radit057/Solar-PV/Solar_Portfolio_Projects_2-5/P2_Gazipur_50kWp_Industrial/P2_Gazipur_50kWp_Industrial_hourly_simulation.csv

 | ghi | poa | tcell | pdc_w | pdc_net_w | pac_w
2026-01-01 00:30:00+06:00 | 0.000 | 0.000 | 15.787 | 0.000 | 0.000 | 0.000
2026-01-01 01:30:00+06:00 | 0.000 | 0.000 | 15.264 | 0.000 | 0.000 | 0.000
2026-01-01 02:30:00+06:00 | 0.000 | 0.000 | 14.994 | 0.000 | 0.000 | 0.000
2026-01-01 03:30:00+06:00 | 0.000 | 0.000 | 14.994 | 0.000 | 0.000 | 0.000
2026-01-01 04:30:00+06:00 | 0.000 | 0.000 | 15.264 | 0.000 | 0.000 | 0.000
2026-01-01 05:30:00+06:00 | 0.000 | 0.000 | 15.787 | 0.000 | 0.000 | 0.000
2026-01-01 06:30:00+06:00 | 0.000 | 0.000 | 16.525 | 0.000 | 0.000 | 0.000
2026-01-01 07:30:00+06:00 | 77.383 | 93.540 | 21.950 | 3693.241 | 3388.515 | 3112.805
2026-01-01 08:30:00+06:00 | 261.454 | 289.607 | 32.434 | 12836.957 | 11777.790 | 11386.707
2026-01-01 09:30:00+06:00 | 425.286 | 461.666 | 41.794 | 20607.043 | 18906.774 | 18373.904
2026-01-01 10:30:00+06:00 | 544.030 | 585.990 | 48.811 | 25800.628 | 23671.840 | 23021.788
2026-01-01 11:30:00+06:00 | 606.860 | 651.769 | 52.894 | 28357.573 | 26017.814 | 25303.473
2026-01-01 12:30:00+06:00 | 608.729 | 653.723 | 53.727 | 28353.316 | 26013.909 | 25299.679
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
