radit057/Solar-PV/Solar_Portfolio_Projects_2-5/P2_Gazipur_50kWp_Industrial/P2_Gazipur_50kWp_Industrial_monthly_simulation.csv

 | GHI_kWh_m2 | POA_kWh_m2 | E_ac_kWh | PR
Jan | 121.100 | 130.651 | 5082.574 | 0.786
Feb | 130.500 | 137.929 | 5252.534 | 0.769
Mar | 167.300 | 172.779 | 6426.839 | 0.751
Apr | 158.600 | 160.329 | 5966.073 | 0.752
May | 152.100 | 151.764 | 5678.534 | 0.756
Jun | 120.400 | 119.570 | 4527.491 | 0.765
Jul | 117.300 | 116.780 | 4447.690 | 0.769
Aug | 124.800 | 125.535 | 4731.529 | 0.761
Sep | 118.700 | 121.018 | 4552.201 | 0.760
Oct | 122.800 | 128.045 | 4856.853 | 0.766
Nov | 114.300 | 122.190 | 4680.217 | 0.774
Dec | 108.500 | 117.185 | 4553.744 | 0.785
