radit057/Solar-PV/Solar_Portfolio_Projects_2-5/P3_Uttara_5kWp_Hybrid/P3_Uttara_5kWp_Hybrid_hourly_simulation.csv

 | ghi | poa | tcell | pdc_w | pdc_net_w | pac_w
2026-01-01 00:30:00+06:00 | 0.000 | 0.000 | 15.787 | 0.000 | 0.000 | 0.000
2026-01-01 01:30:00+06:00 | 0.000 | 0.000 | 15.264 | 0.000 | 0.000 | 0.000
2026-01-01 02:30:00+06:00 | 0.000 | 0.000 | 14.994 | 0.000 | 0.000 | 0.000
2026-01-01 03:30:00+06:00 | 0.000 | 0.000 | 14.994 | 0.000 | 0.000 | 0.000
2026-01-01 04:30:00+06:00 | 0.000 | 0.000 | 15.264 | 0.000 | 0.000 | 0.000
2026-01-01 05:30:00+06:00 | 0.000 | 0.000 | 15.787 | 0.000 | 0.000 | 0.000
2026-01-01 06:30:00+06:00 | 0.000 | 0.000 | 16.525 | 0.000 | 0.000 | 0.000
2026-01-01 07:30:00+06:00 | 77.827 | 124.452 | 20.965 | 534.063 | 490.126 | 454.954
2026-01-01 08:30:00+06:00 | 261.768 | 340.597 | 28.115 | 1575.697 | 1446.066 | 1397.625
2026-01-01 09:30:00+06:00 | 425.409 | 525.580 | 34.415 | 2439.417 | 2238.729 | 2174.900
2026-01-01 10:30:00+06:00 | 544.030 | 658.485 | 39.200 | 3024.946 | 2776.087 | 2699.567
2026-01-01 11:30:00+06:00 | 606.836 | 728.816 | 42.103 | 3318.434 | 3045.430 | 2961.861
2026-01-01 12:30:00+06:00 | 608.784 | 730.989 | 42.903 | 3318.555 | 3045.541 | 2961.969
2026-01-01 13:30:00+06:00 | 549.723 | 664.827 | 41.545 | 3028.338 | 2779.199 | 2702.601
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
