radit057/Solar-PV/Solar_Portfolio_Projects_2-5/P3_Uttara_5kWp_Hybrid/P3_Uttara_5kWp_Hybrid_monthly_simulation.csv

 | GHI_kWh_m2 | POA_kWh_m2 | E_ac_kWh | PR
Jan | 121.100 | 147.241 | 597.774 | 0.820
Feb | 130.500 | 150.238 | 598.446 | 0.805
Mar | 167.300 | 180.569 | 704.789 | 0.789
Apr | 158.600 | 160.993 | 625.860 | 0.785
May | 152.100 | 148.605 | 578.389 | 0.786
Jun | 120.400 | 116.135 | 453.481 | 0.789
Jul | 117.300 | 113.945 | 446.433 | 0.792
Aug | 124.800 | 124.915 | 487.245 | 0.788
Sep | 118.700 | 123.644 | 482.171 | 0.788
Oct | 122.800 | 136.258 | 536.541 | 0.795
Nov | 114.300 | 135.736 | 541.287 | 0.806
Dec | 108.500 | 132.344 | 535.385 | 0.817
