radit057/Solar-PV/Solar_Portfolio_Projects_2-5/P4_AUST_30kWp_Solar_Carport_EV/P4_AUST_30kWp_Solar_Carport_EV_hourly_simulation.csv

 | ghi | poa | tcell | pdc_w | pdc_net_w | pac_w
2026-01-01 00:30:00+06:00 | 0.000 | 0.000 | 15.787 | 0.000 | 0.000 | 0.000
2026-01-01 01:30:00+06:00 | 0.000 | 0.000 | 15.264 | 0.000 | 0.000 | 0.000
2026-01-01 02:30:00+06:00 | 0.000 | 0.000 | 14.994 | 0.000 | 0.000 | 0.000
2026-01-01 03:30:00+06:00 | 0.000 | 0.000 | 14.994 | 0.000 | 0.000 | 0.000
2026-01-01 04:30:00+06:00 | 0.000 | 0.000 | 15.264 | 0.000 | 0.000 | 0.000
2026-01-01 05:30:00+06:00 | 0.000 | 0.000 | 15.787 | 0.000 | 0.000 | 0.000
2026-01-01 06:30:00+06:00 | 0.000 | 0.000 | 16.525 | 0.000 | 0.000 | 0.000
2026-01-01 07:30:00+06:00 | 78.522 | 110.318 | 20.564 | 2750.730 | 2550.059 | 2373.112
2026-01-01 08:30:00+06:00 | 262.270 | 316.566 | 27.432 | 8710.258 | 8074.828 | 7817.895
2026-01-01 09:30:00+06:00 | 425.588 | 495.100 | 33.549 | 13765.265 | 12761.062 | 12406.010
2026-01-01 10:30:00+06:00 | 543.945 | 623.721 | 38.212 | 17211.593 | 15955.974 | 15518.098
2026-01-01 11:30:00+06:00 | 606.586 | 691.781 | 41.051 | 18941.264 | 17559.462 | 17075.149
2026-01-01 12:30:00+06:00 | 608.490 | 693.843 | 41.847 | 18942.767 | 17560.855 | 17076.501
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
