radit057/Solar-PV/Solar_Portfolio_Projects_2-5/P4_AUST_30kWp_Solar_Carport_EV/P4_AUST_30kWp_Solar_Carport_EV_monthly_simulation.csv

 | GHI_kWh_m2 | POA_kWh_m2 | E_ac_kWh | PR
Jan | 121.100 | 139.297 | 3425.817 | 0.828
Feb | 130.500 | 144.466 | 3490.303 | 0.813
Mar | 167.300 | 177.147 | 4196.583 | 0.798
Apr | 158.600 | 161.071 | 3801.596 | 0.795
May | 152.100 | 150.547 | 3560.196 | 0.796
Jun | 120.400 | 118.117 | 2805.403 | 0.800
Jul | 117.300 | 115.629 | 2756.512 | 0.803
Aug | 124.800 | 125.533 | 2977.343 | 0.799
Sep | 118.700 | 122.631 | 2906.542 | 0.798
Oct | 122.800 | 132.487 | 3167.216 | 0.805
Nov | 114.300 | 129.291 | 3125.879 | 0.814
Dec | 108.500 | 125.058 | 3064.289 | 0.825
