radit057/Solar-PV/Solar_Portfolio_Projects_2-5/P5_Rajshahi_8kWp_Solar_Irrigation_Pump/P5_Rajshahi_8kWp_Solar_Irrigation_Pump_hourly_simulation.csv

 | ghi | poa | tcell | pdc_w | pdc_net_w | pac_w
2026-01-01 00:30:00+06:00 | 0.000 | 0.000 | 15.787 | 0.000 | 0.000 | 0.000
2026-01-01 01:30:00+06:00 | 0.000 | 0.000 | 15.264 | 0.000 | 0.000 | 0.000
2026-01-01 02:30:00+06:00 | 0.000 | 0.000 | 14.994 | 0.000 | 0.000 | 0.000
2026-01-01 03:30:00+06:00 | 0.000 | 0.000 | 14.994 | 0.000 | 0.000 | 0.000
2026-01-01 04:30:00+06:00 | 0.000 | 0.000 | 15.264 | 0.000 | 0.000 | 0.000
2026-01-01 05:30:00+06:00 | 0.000 | 0.000 | 15.787 | 0.000 | 0.000 | 0.000
2026-01-01 06:30:00+06:00 | 0.000 | 0.000 | 16.525 | 0.000 | 0.000 | 0.000
2026-01-01 07:30:00+06:00 | 56.338 | 118.765 | 20.804 | 870.219 | 802.430 | 748.932
2026-01-01 08:30:00+06:00 | 239.165 | 353.915 | 28.494 | 2749.846 | 2535.637 | 2456.496
2026-01-01 09:30:00+06:00 | 407.668 | 553.853 | 35.219 | 4289.908 | 3955.730 | 3846.135
2026-01-01 10:30:00+06:00 | 532.802 | 699.766 | 40.373 | 5346.676 | 4930.177 | 4794.764
2026-01-01 11:30:00+06:00 | 602.886 | 781.319 | 43.595 | 5905.490 | 5445.460 | 5294.776
2026-01-01 12:30:00+06:00 | 612.271 | 792.232 | 44.643 | 5965.015 | 5500.348 | 5347.971
2026-01-01 13:30:00+06:00 | 560.226 | 731.628 | 43.443 | 5529.749 | 5098.990 | 4958.697
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
