radit057/Solar-PV/Solar_Portfolio_Projects_2-5/P5_Rajshahi_8kWp_Solar_Irrigation_Pump/P5_Rajshahi_8kWp_Solar_Irrigation_Pump_monthly_simulation.csv

 | GHI_kWh_m2 | POA_kWh_m2 | E_ac_kWh | PR
Jan | 121.100 | 159.712 | 1087.033 | 0.825
Feb | 130.500 | 158.973 | 1060.194 | 0.808
Mar | 167.300 | 184.366 | 1205.126 | 0.792
Apr | 158.600 | 158.849 | 1034.256 | 0.789
May | 152.100 | 143.341 | 934.546 | 0.790
Jun | 120.400 | 111.267 | 727.822 | 0.793
Jul | 117.300 | 109.626 | 719.439 | 0.795
Aug | 124.800 | 122.318 | 799.500 | 0.792
Sep | 118.700 | 124.009 | 810.320 | 0.792
Oct | 122.800 | 141.284 | 932.517 | 0.800
Nov | 114.300 | 145.598 | 974.635 | 0.811
Dec | 108.500 | 143.932 | 977.623 | 0.823
