radit057/Solar-PV/Solar_Portfolio_Projects_2-5/P2_Gazipur_50kWp_Industrial/P2_Gazipur_50kWp_Industrial_drawing.png

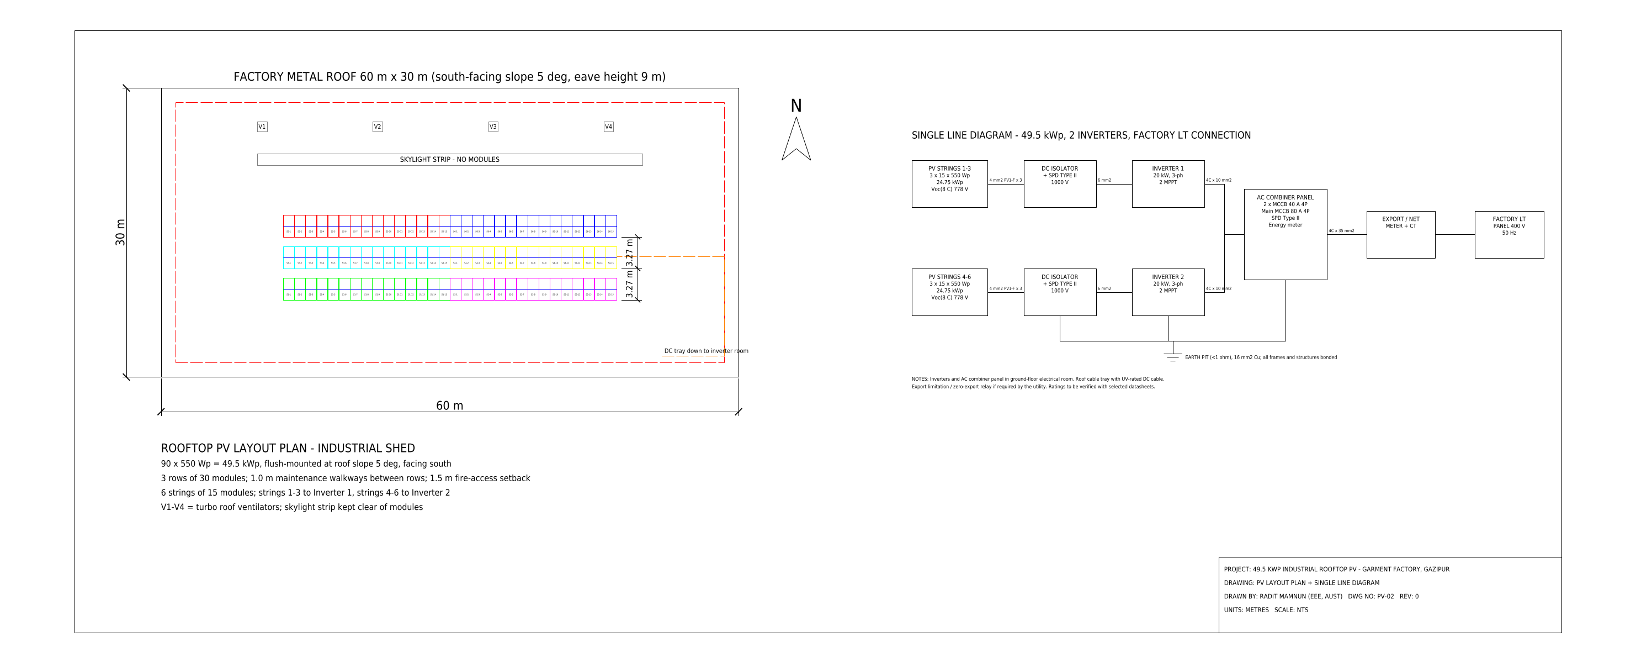
Solar_Portfolio_Projects_2-5/P2_Gazipur_50kWp_Industrial/P2_Gazipur_50kWp_Industrial_drawing.png
