radit057/Solar-PV/Solar_Portfolio_Projects_2-5/P3_Uttara_5kWp_Hybrid/P3_Uttara_5kWp_Hybrid_drawing.png

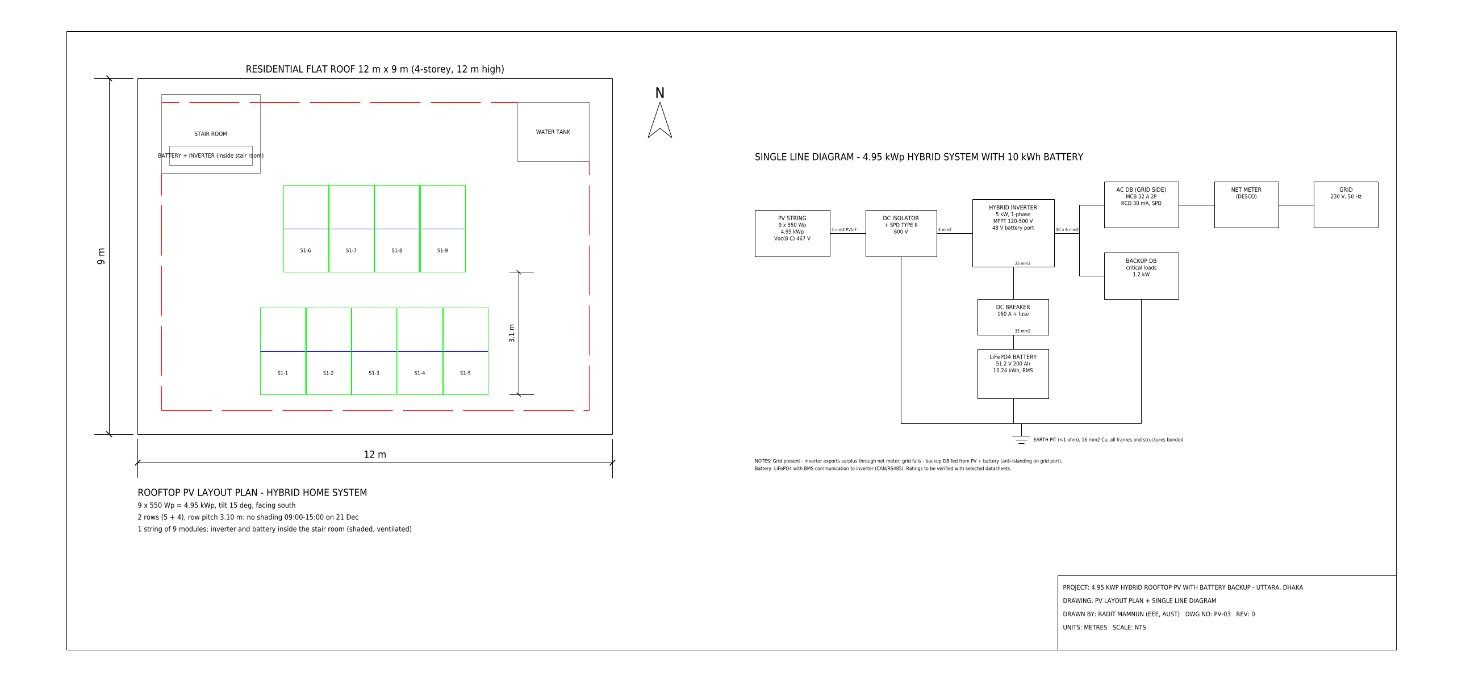
Solar_Portfolio_Projects_2-5/P3_Uttara_5kWp_Hybrid/P3_Uttara_5kWp_Hybrid_drawing.png
