radit057/Solar-PV/Solar_Portfolio_Projects_2-5/P4_AUST_30kWp_Solar_Carport_EV/P4_AUST_30kWp_Solar_Carport_EV_drawing.png

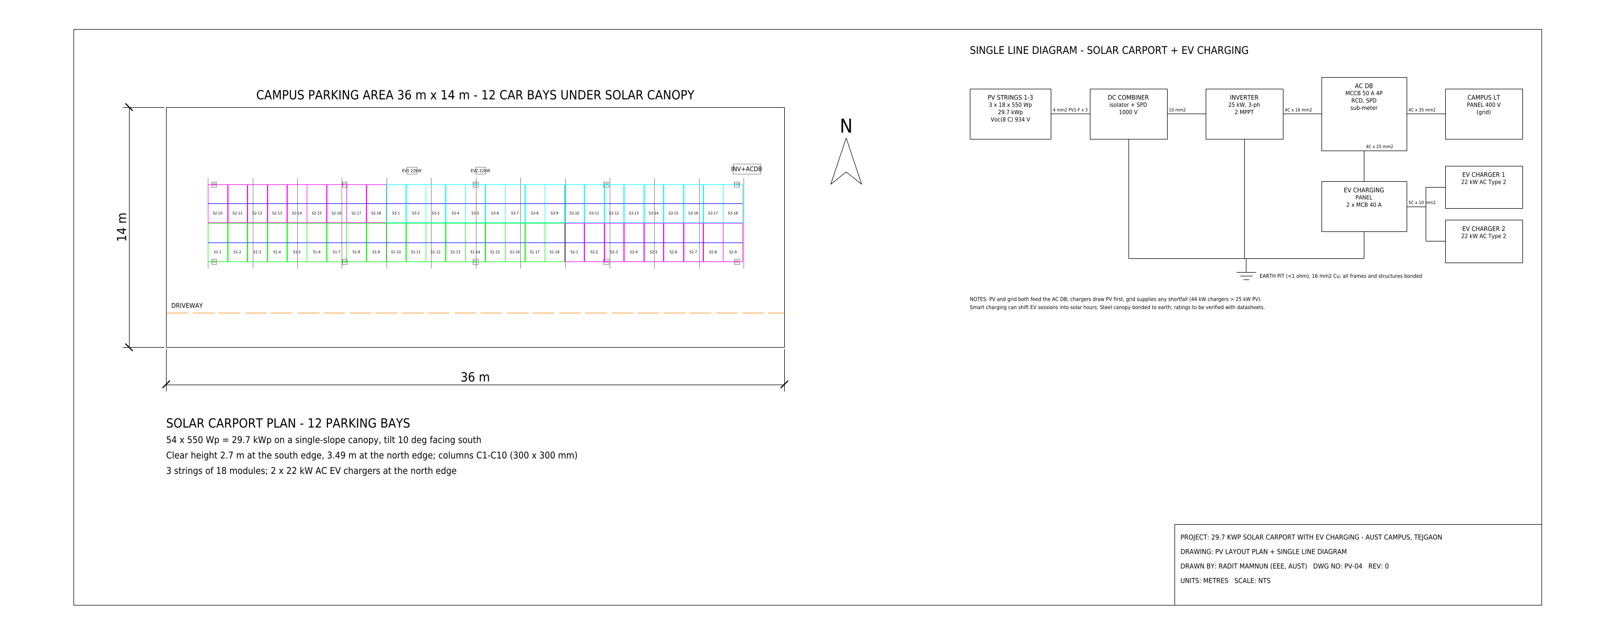
Solar_Portfolio_Projects_2-5/P4_AUST_30kWp_Solar_Carport_EV/P4_AUST_30kWp_Solar_Carport_EV_drawing.png
