radit057/Solar-PV/Solar_Portfolio_Projects_2-5/P4_AUST_30kWp_Solar_Carport_EV/P4_AUST_30kWp_Solar_Carport_EV_fig_ev_share.png

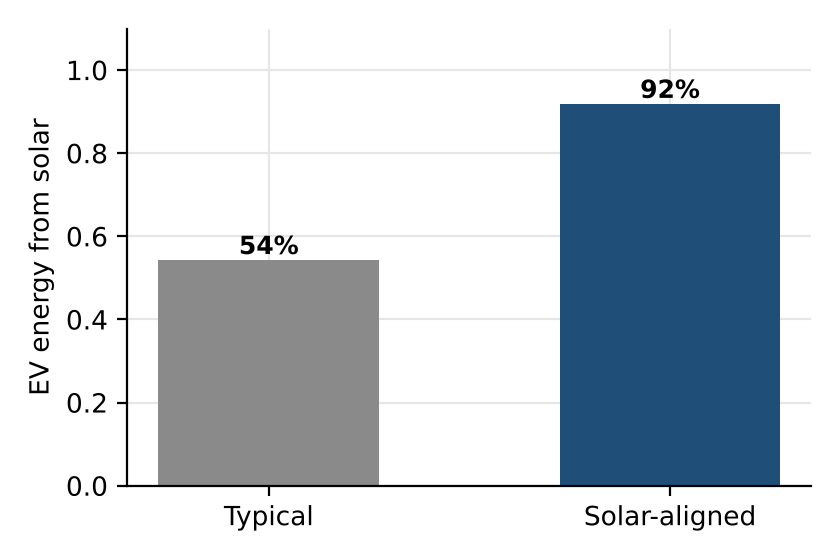
Solar_Portfolio_Projects_2-5/P4_AUST_30kWp_Solar_Carport_EV/P4_AUST_30kWp_Solar_Carport_EV_fig_ev_share.png
