radit057/Solar-PV/Solar_Portfolio_Projects_2-5/P5_Rajshahi_8kWp_Solar_Irrigation_Pump/P5_Rajshahi_8kWp_Solar_Irrigation_Pump_drawing.png

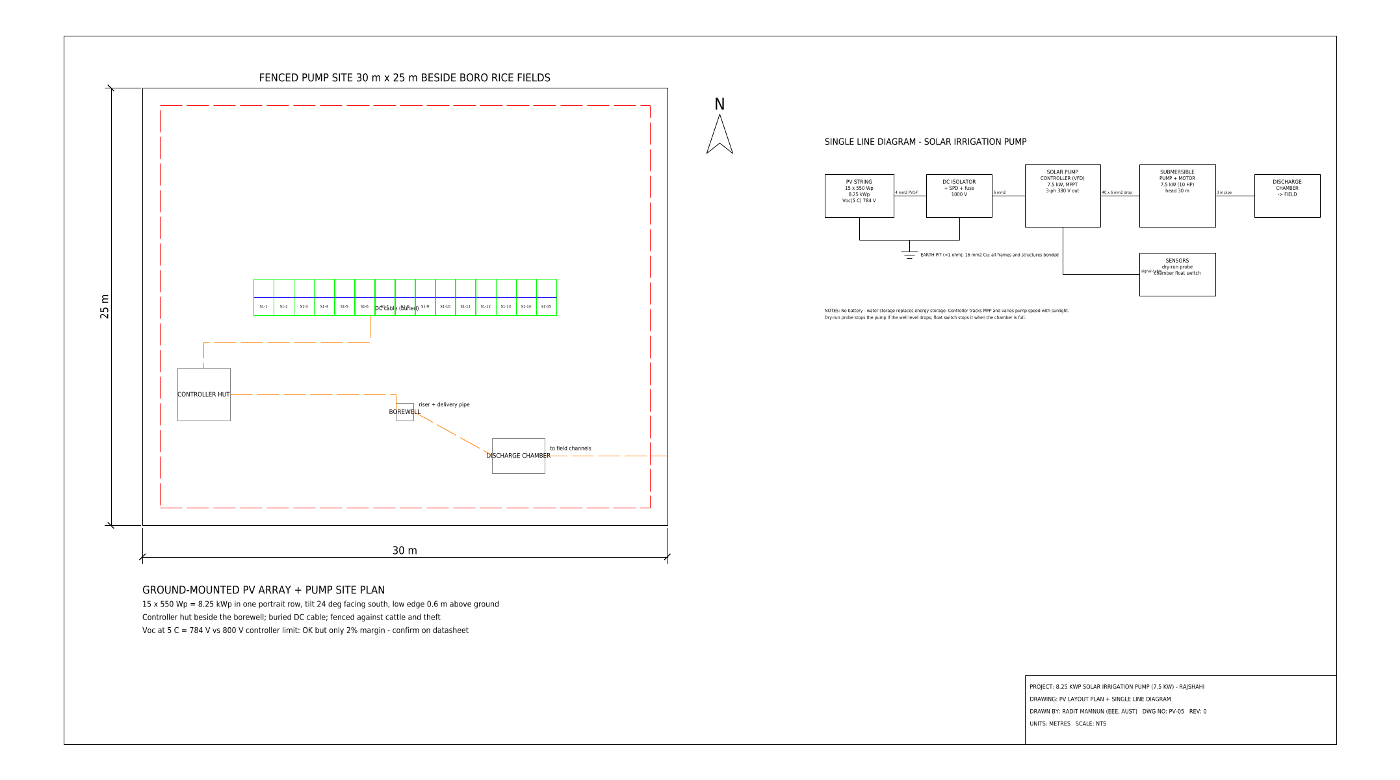
Solar_Portfolio_Projects_2-5/P5_Rajshahi_8kWp_Solar_Irrigation_Pump/P5_Rajshahi_8kWp_Solar_Irrigation_Pump_drawing.png
