radit057/Solar-PV/Rooftop_PV_11kWp_Project/Rooftop_PV_11kWp_Design_Calc.xlsx

Sheet: Inputs
11 kWp Grid-Tied Rooftop PV, Mirpur, Dhaka - Design Inputs
Legend: blue text on yellow = input you can change. Black = formula. All other sheets update automatically.
Parameter | Value | Unit | Note / source
Module rated power (Pmax) | 550 | Wp | Typical 550 Wp mono PERC, 144 half-cell; replace with chosen datasheet
Module Voc (STC) | 49.6 | V | Datasheet
Module Vmp (STC) | 41.9 | V | Datasheet
Module Isc (STC) | 14 | A | Datasheet
Module Imp (STC) | 13.13 | A | Datasheet
Temp. coefficient of Voc | -0.27 | %/degC | Datasheet
Temp. coefficient of Pmax | -0.35 | %/degC | Datasheet
Module length | 2.278 | m | Datasheet
Module width | 1.134 | m | Datasheet
Number of modules | 20 | nos | Fits 20 m x 14 m roof with 1 m setback, see drawing PV-01
Modules per string | 10 | nos | Design choice
Number of strings | 2 | nos | One string per MPPT
Inverter AC rating | 9 | kW | 9 kW three-phase, 2 MPPT (as simulated in PVsyst)
Inverter max DC input voltage | 1000 | V | Inverter datasheet
Inverter MPPT min voltage | 150 | V | Inverter datasheet
Inverter MPPT max voltage | 750 | V | Inverter datasheet
Inverter max input current per MPPT | 16 | A | Inverter datasheet
Minimum ambient temperature, Dhaka | 8 | degC | Approximate record winter low
Maximum cell temperature | 70 | degC | Ambient ~38 degC + ~32 degC rise on rooftop
Tilt angle | 23 | deg | Close to latitude 23.8 N
Performance ratio (PR) | 0.75 | - | Assumed; verify with PVsyst simulation
Grid tariff (avoided cost) | 10 | BDT/kWh | Placeholder: use current DPDC/DESCO commercial tariff

Sheet: String Sizing
String sizing and inverter compatibility check
Check | Value | Unit | Limit | Result
DC array capacity | 11.00 | kWp
DC/AC ratio | 1.22 | - | 1.0 - 1.3 | OK
Voc at min temperature (per module) | 51.88 | V
String Voc at min temperature | 518.77 | V | 1000 | OK
Vmp at max cell temperature (per module) | 35.30 | V
String Vmp at max cell temperature | 353.01 | V | 150 | OK
String Vmp at STC | 419.00 | V | 750 | OK
String design current (1.25 x Isc) | 17.50 | A | 16 | OK (Isc within inverter short-circuit rating)
Total modules check | 20.00 | nos | 20 | OK
Note: string current check uses 1.25 x Isc as the conductor/fuse design current; confirm the inverter's max short-circuit input current on its datasheet.

Sheet: Energy Yield
Monthly energy yield estimate (hand calculation, to be compared with PVsyst)
E = Capacity (kWp) x POA irradiation (kWh/m2) x PR. GHI: approximate long-term Dhaka averages (NASA POWER-type data); tilt factor: approximate GHI-to-23 deg plane gain. Replace with PVGIS/Meteonorm values.
Month | Days | GHI (kWh/m2/day) | Tilt factor | POA (kWh/m2/month) | Energy (kWh) | Specific yield (kWh/kWp)
Jan | 31 | 4.3 | 1.25 | 166.6 | 1374.65625 | 125.0
Feb | 28 | 5 | 1.15 | 161.0 | 1328.25 | 120.8
Mar | 31 | 5.6 | 1.06 | 184.0 | 1518.132 | 138.0
Apr | 30 | 5.9 | 0.98 | 173.5 | 1431.045 | 130.1
May | 31 | 5.6 | 0.92 | 159.7 | 1317.624 | 119.8
Jun | 30 | 4.4 | 0.91 | 120.1 | 990.99 | 90.1
Jul | 31 | 4.3 | 0.92 | 122.6 | 1011.747 | 92.0
Aug | 31 | 4.4 | 0.96 | 130.9 | 1080.288 | 98.2
Sep | 30 | 4.2 | 1.02 | 128.5 | 1060.29 | 96.4
Oct | 31 | 4.5 | 1.12 | 156.2 | 1288.98 | 117.2
Nov | 30 | 4.4 | 1.22 | 161.0 | 1328.58 | 120.8
Dec | 31 | 4.1 | 1.28 | 162.7 | 1342.176 | 122.0
Annual | 365 |  |  | 1827.001 | 15072.75825 | 1370.25075
Annual savings (BDT) | 150727.5825
CO2 avoided (t/yr) | 10.1 | Grid emission factor 0.67 kgCO2/kWh assumed for Bangladesh grid; verify.

Sheet: Cable Sizing
Cable voltage-drop check (copper, resistivity 0.0175 ohm.mm2/m at 20 degC; ~0.0225 at 70 degC used)
Circuit | Type | Length one-way (m) | Current (A) | Size (mm2) | Voltage (V) | Voltage drop (V) | Drop (%) | Limit (%) | Result
String A to combiner | DC | 25 | 13.13 | 4 | 419.00 | 3.69 | 0.88 | 1.5 | OK
String B to combiner | DC | 30 | 13.13 | 4 | 419.00 | 4.43 | 1.06 | 1.5 | OK
Inverter to AC DB | AC 3-ph | 10 | 13.12 | 6 | 400 | 0.85 | 0.21 | 1 | OK
AC DB to MDB via net meter | AC 3-ph | 20 | 13.12 | 10 | 400 | 1.02 | 0.26 | 1 | OK

Sheet: BOQ
Bill of Quantities - 11 kWp rooftop PV
Unit rates left blank on purpose: fill them from current vendor quotes (yellow cells); totals, cost per Wp and payback then calculate.
SL | Item | Specification | Unit | Qty | Unit rate (BDT) | Amount (BDT)
1 | PV module | 550 Wp mono PERC half-cell, IEC 61215/61730 | nos | 20.0 | 0 | 0
2 | Grid-tied inverter | 9 kW, 3-phase, 2 MPPT, IEC 62109/61727 | nos | 1.0 | 0 | 0
3 | Module mounting structure | Hot-dip galvanized / Al, 23 deg fixed tilt, wind-rated | kWp | 11.0 | 0 | 0
4 | DC combiner / isolator box | 2-string, gPV fuses 15 A, 1000 V DC isolator, Type II SPD | set | 1.0 | 0 | 0
5 | DC solar cable | 4 mm2 PV1-F, red + black | m | 121.0 | 0 | 0
6 | DC cable | 6 mm2 PV1-F, combiner to inverter | m | 10.0 | 0 | 0
7 | MC4 connectors | 1000 V, IP67, pairs | pair | 8.0 | 0 | 0
8 | AC cable | 4C x 6 mm2 Cu XLPE, inverter to AC DB | m | 11.0 | 0 | 0
9 | AC cable | 4C x 10 mm2 Cu XLPE, AC DB to MDB | m | 22.0 | 0 | 0
10 | AC distribution board | MCCB 20 A 4P, RCD, Type II AC SPD, IP65 | set | 1.0 | 0 | 0
11 | Earthing system | Earth pit with 16 mm2 Cu conductor, chemical earthing | set | 2.0 | 0 | 0
12 | Lightning protection | ESE/conventional air terminal with down conductor | set | 1.0 | 0 | 0
13 | Bi-directional net meter | As per DPDC/DESCO net metering requirements | nos | 1.0 | 0 | 0
14 | Conduits, trays, accessories | UV-resistant PVC conduit, GI tray, glands, lugs | lot | 1.0 | 0 | 0
15 | Installation, testing & commissioning | Labour, testing per IEC 62446 | lot | 1.0 | 0 | 0
 |  |  |  |  | Total | 0
 |  |  |  |  | Cost per Wp | 0.00
 |  |  |  |  | Simple payback (yr) | 0.0
