radit057/Solar-PV/Solar_Portfolio_Projects_2-5/P2_Gazipur_50kWp_Industrial/P2_Gazipur_50kWp_Industrial_Design_Calc.xlsx

Sheet: Inputs
49.5 kWp Industrial Rooftop PV - Garment Factory, Gazipur
Legend: blue on yellow = design input; black = calculated value.
Parameter | Value | Unit | Note / source
Module rated power (Pmax) | 550 | Wp | Generic 550 Wp mono half-cell; replace with chosen datasheet
Module Voc (STC) | 49.6 | V | Datasheet
Module Vmp (STC) | 41.9 | V | Datasheet
Module Isc (STC) | 14 | A | Datasheet
Module Imp (STC) | 13.13 | A | Datasheet
Temp. coefficient of Voc | -0.27 | %/degC | Datasheet
Temp. coefficient of Pmax | -0.35 | %/degC | Datasheet
Number of modules | 90 | nos | Client phase-1 target ~50 kWp (roof could host far more)
Modules per string | 15 | nos | Design choice
Number of strings | 6 | nos | 3 strings per inverter (MPPT1: 2 strings, MPPT2: 1 string)
Inverter / controller AC rating | 20 | kW | 2 x 20 kW three-phase string inverters, 2 MPPT each
Number of inverters | 2 | nos | -
Inverter max DC input voltage | 1100 | V | Inverter datasheet
Inverter MPPT min voltage | 200 | V | Inverter datasheet
Inverter MPPT max voltage | 1000 | V | Inverter datasheet
Inverter max input current per MPPT | 32 | A | Inverter datasheet
Strings per MPPT (max) | 2 | nos | Design choice
Minimum ambient temperature | 8 | degC | Approx. record winter low at site
Maximum cell temperature | 75 | degC | Flush on hot metal roof: little ventilation, so higher cell temperature
Tilt angle | 5 | deg | Roof slope 5 deg; modules flush-mounted on rails (no tilt frames)
Performance ratio (PR) | 0.78 | - | Assumed for hand estimate; verify with PVsyst
Electricity tariff (avoided cost) | 12 | BDT/kWh | Placeholder: use current tariff for this customer class

Sheet: String Sizing
String sizing and inverter compatibility
Check | Value | Unit | Limit | Result
DC array capacity |  | kWp
DC/AC ratio |  | - | 1.0 - 1.3
Voc at min temperature (per module) |  | V
String Voc at min temperature |  | V
Vmp at max cell temperature (per module) |  | V
String Vmp at max cell temperature |  | V
String Vmp at STC |  | V
MPPT input current (strings per MPPT x Imp) |  | A
Total modules check |  | nos

Sheet: Energy Yield
Monthly energy estimate (hand calculation - verify with PVsyst)
E = kWp x POA x PR. GHI: Meteonorm monthly values for Dhaka (PVsyst). Tilt factor = 1 + (F23 - 1) x tilt/23, an approximation scaled from the PVsyst 23 deg transposition. Replace with site data for best accuracy.
Month | GHI (kWh/m2) | F23 (PVsyst) | Tilt factor | POA (kWh/m2) | Energy (kWh) | kWh/kWp
Jan | 121.1 | 1.277
Feb | 130.5 | 1.194
Mar | 167.3 | 1.095
Apr | 158.6 | 0.996
May | 152.1 | 0.948
Jun | 120.4 | 0.924
Jul | 117.3 | 0.932
Aug | 124.8 | 0.971
Sep | 118.7 | 1.029
Oct | 122.8 | 1.121
Nov | 114.3 | 1.243
Dec | 108.5 | 1.29
Annual
Average energy per day (kWh)
Annual value of energy (BDT)
CO2 avoided (t/yr, 0.67 kg/kWh assumed)

Sheet: BOQ
Bill of Quantities - 49.5 kWp industrial rooftop, Gazipur
Unit rates left blank on purpose: fill from current vendor quotes (yellow cells); totals then calculate.
SL | Item | Specification | Unit | Qty | Unit rate (BDT) | Amount (BDT)
1 | PV module | 550 Wp mono half-cell, IEC 61215/61730 | nos | 90
2 | String inverter | 20 kW, 3-phase, 2 MPPT, IEC 62109/61727 | nos | 2
3 | Roof mounting rails + clamps | Aluminium rail on trapezoidal metal roof, flush 5 deg | kWp | 49.5
4 | DC isolator + SPD box | 1000 V DC isolator, Type II SPD, per inverter | set | 2
5 | DC solar cable | 4 mm2 PV1-F, red + black (6 strings x 2 x 60 m) | m | 720
6 | MC4 connectors | 1000 V, IP67 | pair | 16
7 | AC cable | 4C x 10 mm2 Cu XLPE, inverters to AC combiner | m | 30
8 | AC cable | 4C x 35 mm2 Cu XLPE, AC combiner to LT panel | m | 40
9 | AC combiner panel | 2 x MCCB 40 A, main MCCB 80 A, SPD, energy meter | set | 1
10 | Export / net meter + CTs | As per utility (REB/DESCO) requirement | set | 1
11 | Cable tray | GI perforated tray with cover, roof + riser | m | 80
12 | Roof walkway | FRP grating walkway for O&M | m | 100
13 | Earthing | Earth pits + 16 mm2 Cu, rails bonded | set | 3
14 | Lightning protection | Air terminals + down conductors | set | 2
15 | Installation, testing & commissioning | Labour, testing per IEC 62446 | lot | 1
 |  |  |  |  | Total
 |  |  |  |  | Cost per Wp

Sheet: Simulation Parameters
PVsyst simulation parameters
Step | Parameter | Value
1. Project | Project type | Grid-connected
1. Project | Site / weather | Gazipur: 23.99 N, 90.42 E, UTC+6; Meteonorm 9.0 monthly data, synthetic hourly year
2. Orientation | Field type / tilt / azimuth | Fixed tilted plane, tilt 5 deg, azimuth 0 deg (south)
3. System | Planned power | 49.5 kWp
3. System | PV module | Mono 550 Wp half-cell
3. System | Inverter | 20 kW three-phase, 2 MPPT, 2 units, Multi-MPPT
3. System | Array design | 15 modules in series x 6 strings, Pnom ratio 1.24
4. Detailed losses | Thermal | Semi-integrated / close roof, Uc 20 W/m2K (flush on metal roof)
4. Detailed losses | Soiling | 4% (industrial dust, Gazipur)
5. Near shadings | 3D scene | Building 60x30x9 m; 3 PV tables (30 x 1 portrait, 5 deg) at z = 9.15 m; 4 ventilator boxes 1x1x1.2 m; Linear shadings
6. Target | Specific yield / PR | 1,250-1,350 kWh/kWp/yr, PR 0.76-0.82
