radit057/Solar-PV/Solar_Portfolio_Projects_2-5/P3_Uttara_5kWp_Hybrid/P3_Uttara_5kWp_Hybrid_Design_Calc.xlsx

Sheet: Inputs
4.95 kWp Hybrid Rooftop PV with Battery Backup - Uttara, Dhaka
Legend: blue on yellow = design input; black = calculated value.
Parameter | Value | Unit | Note / source
Module rated power (Pmax) | 550 | Wp | Generic 550 Wp mono half-cell; replace with chosen datasheet
Module Voc (STC) | 49.6 | V | Datasheet
Module Vmp (STC) | 41.9 | V | Datasheet
Module Isc (STC) | 14 | A | Datasheet
Module Imp (STC) | 13.13 | A | Datasheet
Temp. coefficient of Voc | -0.27 | %/degC | Datasheet
Temp. coefficient of Pmax | -0.35 | %/degC | Datasheet
Number of modules | 9 | nos | Limited by roof space after tank, stair room and setbacks
Modules per string | 9 | nos | Design choice
Number of strings | 1 | nos | Single string into MPPT 1
Inverter / controller AC rating | 5 | kW | 5 kW single-phase hybrid inverter, 48 V battery
Number of inverters | 1 | nos | -
Inverter max DC input voltage | 550 | V | Inverter datasheet
Inverter MPPT min voltage | 120 | V | Inverter datasheet
Inverter MPPT max voltage | 500 | V | Inverter datasheet
Inverter max input current per MPPT | 16 | A | Inverter datasheet
Strings per MPPT (max) | 1 | nos | Design choice
Minimum ambient temperature | 8 | degC | Approx. record winter low at site
Maximum cell temperature | 70 | degC | Ambient ~38 degC + mounting rise
Tilt angle | 15 | deg | 15 deg: compact rows on a small roof, still good yield
Performance ratio (PR) | 0.75 | - | Assumed for hand estimate; verify with PVsyst
Electricity tariff (avoided cost) | 9 | BDT/kWh | Placeholder: use current tariff for this customer class

Sheet: String Sizing
String sizing and inverter compatibility
Check | Value | Unit | Limit | Result
DC array capacity |  | kWp
DC/AC ratio |  | - | 0.9 - 1.3
Voc at min temperature (per module) |  | V
String Voc at min temperature |  | V
Vmp at max cell temperature (per module) |  | V
String Vmp at max cell temperature |  | V
String Vmp at STC |  | V
MPPT input current (strings per MPPT x Imp) |  | A
Total modules check |  | nos

Sheet: Energy Yield
Monthly energy estimate (hand calculation - verify with PVsyst)
E = kWp x POA x PR. GHI: Meteonorm monthly values for Dhaka (PVsyst). Tilt factor = 1 + (F23 - 1) x tilt/23, an approximation scaled from the PVsyst 23 deg transposition. Replace with site data for best accuracy.
Month | GHI (kWh/m2) | F23 (PVsyst) | Tilt factor | POA (kWh/m2) | Energy (kWh) | kWh/kWp
Jan | 121.1 | 1.277
Feb | 130.5 | 1.194
Mar | 167.3 | 1.095
Apr | 158.6 | 0.996
May | 152.1 | 0.948
Jun | 120.4 | 0.924
Jul | 117.3 | 0.932
Aug | 124.8 | 0.971
Sep | 118.7 | 1.029
Oct | 122.8 | 1.121
Nov | 114.3 | 1.243
Dec | 108.5 | 1.29
Annual
Average energy per day (kWh)
Annual value of energy (BDT)
CO2 avoided (t/yr, 0.67 kg/kWh assumed)

Sheet: Battery Sizing
Battery backup sizing (load-shedding)
Parameter | Value | Unit | Note
Critical load (lights, fans, router, fridge) | 1.20 | kW | Input
Backup duration needed | 6.00 | h | Input: worst-case daily load-shedding
Usable depth of discharge (LiFePO4) | 0.90 | - | Input
Battery + inverter round-trip efficiency | 0.92 | - | Input
Energy needed from battery |  | kWh
Required nominal battery capacity |  | kWh
Selected battery voltage | 51.20 | V | 16S LiFePO4
Selected battery capacity | 200.00 | Ah
Selected battery energy |  | kWh
Check
Battery charge time from PV (avg day, 70% to battery) |  | h | Approx., assumes 10 sun hours

Sheet: BOQ
Bill of Quantities - 4.95 kWp hybrid + battery, Uttara
Unit rates left blank on purpose: fill from current vendor quotes (yellow cells); totals then calculate.
SL | Item | Specification | Unit | Qty | Unit rate (BDT) | Amount (BDT)
1 | PV module | 550 Wp mono half-cell, IEC 61215/61730 | nos | 9
2 | Hybrid inverter | 5 kW, 1-phase, 48 V, on/off-grid, IEC 62109 | nos | 1
3 | Lithium battery | LiFePO4 51.2 V 200 Ah (10.24 kWh) with BMS | nos | 1
4 | Battery rack + DC breaker | 160 A DC breaker, fuse, busbar | set | 1
5 | Mounting structure | HDG / aluminium, 15 deg fixed tilt | kWp | 4.95
6 | DC isolator + SPD | 600 V DC isolator, Type II SPD | set | 1
7 | DC solar cable | 4 mm2 PV1-F, red + black | m | 40
8 | Battery cable | 35 mm2 flexible Cu with lugs | m | 4
9 | AC cable | 3C x 6 mm2 and 3C x 4 mm2 Cu | m | 30
10 | AC DB (grid side) | MCB 32 A 2P, RCD 30 mA, Type II SPD | set | 1
11 | Backup DB | Critical-load DB with MCBs | set | 1
12 | Net meter | Bi-directional, as per DESCO | nos | 1
13 | Earthing | Earth pit + 16 mm2 Cu | set | 2
14 | Installation, testing & commissioning | Labour, testing per IEC 62446 | lot | 1
 |  |  |  |  | Total
 |  |  |  |  | Cost per Wp

Sheet: Simulation Parameters
PVsyst simulation parameters
Step | Parameter | Value
1. Project | Project type | Grid-connected
1. Project | Site / weather | Uttara, Dhaka: 23.87 N, 90.4 E, UTC+6; Meteonorm 9.0 monthly data, synthetic hourly year
2. Orientation | Tilt / azimuth | Fixed tilted plane, 15 deg, azimuth 0 deg
3. System | Storage | Li-ion (LFP) 51.2 V, 200 Ah; strategy: self-consumption
3. System | PV + inverter | 9 x 550 Wp in 1 string; 5 kW single-phase hybrid inverter
3. System | User's needs | Household profile, 15 kWh/day with evening peak
4. Detailed losses | Thermal / soiling | Free mounted (Uc 29 W/m2K); soiling 3%
5. Near shadings | 3D scene | House 12x9x12 m; 2 PV tables (5 and 4 modules, 15 deg) at z = 12.3 m; tank 1.8x1.5x1.5; stair room 2.5x2x2.5
6. Target | Production / indicators | 6.0-6.7 MWh/yr; self-consumption and solar fraction
