radit057/Solar-PV/Solar_Portfolio_Projects_2-5/P4_AUST_30kWp_Solar_Carport_EV/P4_AUST_30kWp_Solar_Carport_EV_Design_Calc.xlsx

Sheet: Inputs
29.7 kWp Solar Carport with EV Charging - AUST Campus, Tejgaon
Legend: blue on yellow = design input; black = calculated value.
Parameter | Value | Unit | Note / source
Module rated power (Pmax) | 550 | Wp | Generic 550 Wp mono half-cell; replace with chosen datasheet
Module Voc (STC) | 49.6 | V | Datasheet
Module Vmp (STC) | 41.9 | V | Datasheet
Module Isc (STC) | 14 | A | Datasheet
Module Imp (STC) | 13.13 | A | Datasheet
Temp. coefficient of Voc | -0.27 | %/degC | Datasheet
Temp. coefficient of Pmax | -0.35 | %/degC | Datasheet
Number of modules | 54 | nos | Two portrait rows of 27 modules over 12 bays (2.6 m each)
Modules per string | 18 | nos | Design choice
Number of strings | 3 | nos | MPPT1: strings 1+2, MPPT2: string 3
Inverter / controller AC rating | 25 | kW | 25 kW three-phase string inverter, 2 MPPT
Number of inverters | 1 | nos | -
Inverter max DC input voltage | 1100 | V | Inverter datasheet
Inverter MPPT min voltage | 200 | V | Inverter datasheet
Inverter MPPT max voltage | 1000 | V | Inverter datasheet
Inverter max input current per MPPT | 32 | A | Inverter datasheet
Strings per MPPT (max) | 2 | nos | Design choice
Minimum ambient temperature | 8 | degC | Approx. record winter low at site
Maximum cell temperature | 65 | degC | Open canopy: well ventilated
Tilt angle | 10 | deg | 10 deg canopy: rain run-off, low wind load, enough clear height
Performance ratio (PR) | 0.8 | - | Assumed for hand estimate; verify with PVsyst
Electricity tariff (avoided cost) | 10 | BDT/kWh | Placeholder: use current tariff for this customer class

Sheet: String Sizing
String sizing and inverter compatibility
Check | Value | Unit | Limit | Result
DC array capacity |  | kWp
DC/AC ratio |  | - | 1.0 - 1.3
Voc at min temperature (per module) |  | V
String Voc at min temperature |  | V
Vmp at max cell temperature (per module) |  | V
String Vmp at max cell temperature |  | V
String Vmp at STC |  | V
MPPT input current (strings per MPPT x Imp) |  | A
Total modules check |  | nos

Sheet: Energy Yield
Monthly energy estimate (hand calculation - verify with PVsyst)
E = kWp x POA x PR. GHI: Meteonorm monthly values for Dhaka (PVsyst). Tilt factor = 1 + (F23 - 1) x tilt/23, an approximation scaled from the PVsyst 23 deg transposition. Replace with site data for best accuracy.
Month | GHI (kWh/m2) | F23 (PVsyst) | Tilt factor | POA (kWh/m2) | Energy (kWh) | kWh/kWp
Jan | 121.1 | 1.277
Feb | 130.5 | 1.194
Mar | 167.3 | 1.095
Apr | 158.6 | 0.996
May | 152.1 | 0.948
Jun | 120.4 | 0.924
Jul | 117.3 | 0.932
Aug | 124.8 | 0.971
Sep | 118.7 | 1.029
Oct | 122.8 | 1.121
Nov | 114.3 | 1.243
Dec | 108.5 | 1.29
Annual
Average energy per day (kWh)
Annual value of energy (BDT)
CO2 avoided (t/yr, 0.67 kg/kWh assumed)

Sheet: EV Charging
How many EVs can the carport charge?
Parameter | Value | Unit | Note
Average PV energy per day |  | kWh/day | From Energy Yield sheet
Energy delivered per EV charging session | 20.0 | kWh | Input: e.g. 40 kWh car charged 20%->70%
Charger efficiency | 0.9 | - | Input
EV sessions fully covered by solar per day |  | sessions
EV energy use | 0.2 | kWh/km | Input: typical small EV
Solar driving range added per day |  | km/day
Installed charger capacity | 44.0 | kW | 2 x 22 kW AC chargers
PV inverter AC rating |  | kW
Peak grid import if both chargers run at noon |  | kW | Assumes PV at 85% of inverter rating
Note | Grid supplies the gap; smart scheduling (my research) shifts charging into solar hours

Sheet: BOQ
Bill of Quantities - 29.7 kWp solar carport + EV charging
Unit rates left blank on purpose: fill from current vendor quotes (yellow cells); totals then calculate.
SL | Item | Specification | Unit | Qty | Unit rate (BDT) | Amount (BDT)
1 | PV module | 550 Wp mono half-cell, IEC 61215/61730 | nos | 54
2 | String inverter | 25 kW, 3-phase, 2 MPPT, IEC 62109/61727 | nos | 1
3 | Carport steel structure | HDG steel, single slope 10 deg, 12 bays, 2.7 m clear height | lot | 1
4 | Column foundations | RCC pad footing per structural design | nos | 10
5 | DC combiner box | 3-string, isolator, Type II SPD | set | 1
6 | DC solar cable | 4 mm2 PV1-F (3 strings x 2 x 50 m) | m | 300
7 | AC cables | 4C x 16, 4C x 25, 4C x 35 mm2 Cu XLPE | lot | 1
8 | AC DB | MCCB 50 A 4P, RCD, SPD, sub-meter | set | 1
9 | EV charger | 22 kW AC, Type 2, OCPP, RFID | nos | 2
10 | EV charging panel | 2 x MCB 40 A 4P + RCD Type A/B | set | 1
11 | Earthing + lightning protection | Earth pits, bonding of canopy, air terminals | set | 1
12 | Under-canopy LED lights | IP65, 40 W | nos | 12
13 | Installation, testing & commissioning | Labour, testing per IEC 62446 | lot | 1
 |  |  |  |  | Total
 |  |  |  |  | Cost per Wp

Sheet: Simulation Parameters
PVsyst simulation parameters
Step | Parameter | Value
1. Project | Project type | Grid-connected
1. Project | Site / weather | AUST, Tejgaon, Dhaka: 23.76 N, 90.41 E, UTC+6; Meteonorm 9.0 monthly data, synthetic hourly year
2. Orientation | Tilt / azimuth | Fixed tilted plane, 10 deg, azimuth 0 deg
3. System | PV + inverter | 18 modules in series x 3 strings; 25 kW three-phase inverter, Multi-MPPT
3. System | User's needs | EV charging profile: 4 sessions x 20 kWh on working days
4. Detailed losses | Thermal / soiling | Free mounted with air circulation (Uc 29 W/m2K); soiling 3%
5. Near shadings | 3D scene | Two PV tables (27 x 1 portrait) at z = 2.7 m and 3.1 m, tilt 10 deg
6. Target | Specific yield / PR | 1,250-1,350 kWh/kWp/yr (37-40 MWh/yr), PR ~0.80
