radit057/Solar-PV/Solar_Portfolio_Projects_2-5/P5_Rajshahi_8kWp_Solar_Irrigation_Pump/P5_Rajshahi_8kWp_Solar_Irrigation_Pump_Design_Calc.xlsx

Sheet: Inputs
8.25 kWp Solar Irrigation Pump (7.5 kW) - Rajshahi
Legend: blue on yellow = design input; black = calculated value.
Parameter | Value | Unit | Note / source
Module rated power (Pmax) | 550 | Wp | Generic 550 Wp mono half-cell; replace with chosen datasheet
Module Voc (STC) | 49.6 | V | Datasheet
Module Vmp (STC) | 41.9 | V | Datasheet
Module Isc (STC) | 14 | A | Datasheet
Module Imp (STC) | 13.13 | A | Datasheet
Temp. coefficient of Voc | -0.27 | %/degC | Datasheet
Temp. coefficient of Pmax | -0.35 | %/degC | Datasheet
Number of modules | 15 | nos | Sized ~1.1x the 7.5 kW pump; 15 in series fits the controller's MPPT window
Modules per string | 15 | nos | Design choice
Number of strings | 1 | nos | Single string
Inverter / controller AC rating | 7.5 | kW | 7.5 kW solar pump controller (VFD with MPPT), 3-ph 380 V output
Number of inverters | 1 | nos | -
Inverter max DC input voltage | 800 | V | Inverter datasheet
Inverter MPPT min voltage | 450 | V | Inverter datasheet
Inverter MPPT max voltage | 750 | V | Inverter datasheet
Inverter max input current per MPPT | 20 | A | Inverter datasheet
Strings per MPPT (max) | 1 | nos | Design choice
Minimum ambient temperature | 5 | degC | Approx. record winter low at site
Maximum cell temperature | 70 | degC | Ambient ~38 degC + mounting rise
Tilt angle | 24 | deg | Tilt = latitude (24 deg); irrigation demand peaks in dry season (Jan-Apr)
Performance ratio (PR) | 0.8 | - | Assumed for hand estimate; verify with PVsyst
Electricity tariff (avoided cost) | 25 | BDT/kWh | Placeholder: use current tariff for this customer class

Sheet: String Sizing
String sizing and inverter compatibility
Check | Value | Unit | Limit | Result
DC array capacity |  | kWp
DC/AC ratio |  | - | 1.0 - 1.5
Voc at min temperature (per module) |  | V
String Voc at min temperature |  | V
Vmp at max cell temperature (per module) |  | V
String Vmp at max cell temperature |  | V
String Vmp at STC |  | V
MPPT input current (strings per MPPT x Imp) |  | A
Total modules check |  | nos

Sheet: Energy Yield
Monthly energy estimate (hand calculation - verify with PVsyst)
E = kWp x POA x PR. GHI: Meteonorm monthly values for Dhaka (PVsyst). Tilt factor = 1 + (F23 - 1) x tilt/23, an approximation scaled from the PVsyst 23 deg transposition. Replace with site data for best accuracy.
Month | GHI (kWh/m2) | F23 (PVsyst) | Tilt factor | POA (kWh/m2) | Energy (kWh) | kWh/kWp
Jan | 121.1 | 1.277
Feb | 130.5 | 1.194
Mar | 167.3 | 1.095
Apr | 158.6 | 0.996
May | 152.1 | 0.948
Jun | 120.4 | 0.924
Jul | 117.3 | 0.932
Aug | 124.8 | 0.971
Sep | 118.7 | 1.029
Oct | 122.8 | 1.121
Nov | 114.3 | 1.243
Dec | 108.5 | 1.29
Annual
Average energy per day (kWh)
Annual value of energy (BDT)
CO2 avoided (t/yr, 0.67 kg/kWh assumed)

Sheet: Water Output
Daily water delivery and irrigable area
Parameter | Value | Unit | Note
Total dynamic head (static + drawdown + friction) | 30 | m | Input: 18 m static + 7 m drawdown + 5 m losses
Wire-to-water efficiency (controller x motor x pump) | 0.45 | - | Input: typical submersible
Peak crop water need (Boro rice) | 8 | mm/day | Input
Pump rated power |  | kW
Month | PV energy (kWh) | Water (m3/month) | Water (m3/day) | Area at peak need (ha)
Jan
Feb
Mar
Apr
May
Jun
Jul
Aug
Sep
Oct
Nov
Dec
Year
Diesel avoided vs diesel pump-set (rough) |  | litres/yr, assuming ~0.3 l diesel per kWh of pump energy

Sheet: BOQ
Bill of Quantities - 8.25 kWp solar irrigation pump, Rajshahi
Unit rates left blank on purpose: fill from current vendor quotes (yellow cells); totals then calculate.
SL | Item | Specification | Unit | Qty | Unit rate (BDT) | Amount (BDT)
1 | PV module | 550 Wp mono half-cell, IEC 61215/61730 | nos | 15
2 | Solar pump controller | 7.5 kW VFD with MPPT, 3-ph 380 V output, IP65 | nos | 1
3 | Submersible pump set | 7.5 kW (10 HP) stainless steel, 3-ph, head 30-40 m | set | 1
4 | Ground mounting structure | HDG steel, 24 deg, concrete piers | kWp | 8.25
5 | DC isolator + SPD + fuse | 1000 V | set | 1
6 | DC solar cable | 4 mm2 PV1-F, buried in conduit | m | 80
7 | Pump drop cable | 4C x 6 mm2 flat submersible cable | m | 50
8 | Riser + delivery pipe | 3 in uPVC / GI | m | 40
9 | Sensors | Dry-run probe + float switch | set | 1
10 | Controller hut + discharge chamber | Brick/RCC civil works | lot | 1
11 | Fencing | GI wire mesh fence with gate | m | 110
12 | Earthing + lightning arrester | Earth pits + air terminal | set | 1
13 | Installation, testing & commissioning | Labour, flow test | lot | 1
 |  |  |  |  | Total
 |  |  |  |  | Cost per Wp

Sheet: Simulation Parameters
PVsyst simulation parameters
Step | Parameter | Value
1. Project | Project type | Pumping system: deep well to storage
1. Project | Site | Rajshahi: 24.37 N, 88.60 E, UTC+6; Meteonorm 9.0 monthly data
2. Orientation | Tilt / azimuth | Fixed tilted plane, 24 deg, azimuth 0 deg
3. Hydraulic circuit | Well | Static level 18 m, specific drawdown ~0.5 m/(m3/h), pump depth 30 m
3. Hydraulic circuit | Storage | Discharge chamber modelled as a 20 m3 tank, outlet at ground level
3. Water needs | Daily demand | 150 m3/day in Jan-Apr (Boro), 60 m3/day other months
4. System | Pump | Submersible centrifugal pump, 7.5 kW, 3-phase
4. System | Controller | MPPT controller with AC (inverter) output for 3-phase motor
4. System | PV array | 15 x 550 Wp in series, 1 string
5. Target | Water delivered | 140-200 m3/day in dry months; missing-water fraction
