radit057/Solar-PV/(list of files, cad)

Other CAD files:
Rooftop_PV_11kWp_Project/Rooftop_PV_11kWp_Layout_SLD_R2000.dxf
Solar_Portfolio_Projects_2-5/P2_Gazipur_50kWp_Industrial/P2_Gazipur_50kWp_Industrial_Layout_SLD.dxf
Solar_Portfolio_Projects_2-5/P3_Uttara_5kWp_Hybrid/P3_Uttara_5kWp_Hybrid_Layout_SLD.dxf
Solar_Portfolio_Projects_2-5/P4_AUST_30kWp_Solar_Carport_EV/P4_AUST_30kWp_Solar_Carport_EV_Layout_SLD.dxf
Solar_Portfolio_Projects_2-5/P5_Rajshahi_8kWp_Solar_Irrigation_Pump/P5_Rajshahi_8kWp_Solar_Irrigation_Pump_Layout_SLD.dxf
Rooftop_PV_11kWp_Project/Rooftop_11kWp_Mirpur.skp
Rooftop_PV_11kWp_Project/Rooftop_PV_11kWp_Layout_SLD_R2000.dwg
Solar_Portfolio_Projects_2-5/P2_Gazipur_50kWp_Industrial/P2 gazipur 50kwp industrial sketchup model.skp
Solar_Portfolio_Projects_2-5/P2_Gazipur_50kWp_Industrial/P2_Gazipur_50kWp_Industrial_Layout_SLD.dwg
Solar_Portfolio_Projects_2-5/P3_Uttara_5kWp_Hybrid/P3 uttara 5kwp hybrid sketchup model.skp
Solar_Portfolio_Projects_2-5/P3_Uttara_5kWp_Hybrid/P3_Uttara_5kWp_Hybrid_Layout_SLD.dwg
Solar_Portfolio_Projects_2-5/P4_AUST_30kWp_Solar_Carport_EV/P4 aust 30kwp solar carport ev sketchup model.skp
Solar_Portfolio_Projects_2-5/P4_AUST_30kWp_Solar_Carport_EV/P4_AUST_30kWp_Solar_Carport_EV_Layout_SLD.dwg
Solar_Portfolio_Projects_2-5/P5_Rajshahi_8kWp_Solar_Irrigation_Pump/P5 rajshahi 8kwp solar irrigation pump sketchup model.skp
Solar_Portfolio_Projects_2-5/P5_Rajshahi_8kWp_Solar_Irrigation_Pump/P5_Rajshahi_8kWp_Solar_Irrigation_Pump_Layout_SLD.dwg
