radit057/Solar-PV/Solar_Portfolio_Projects_2-5/validation_P1.png

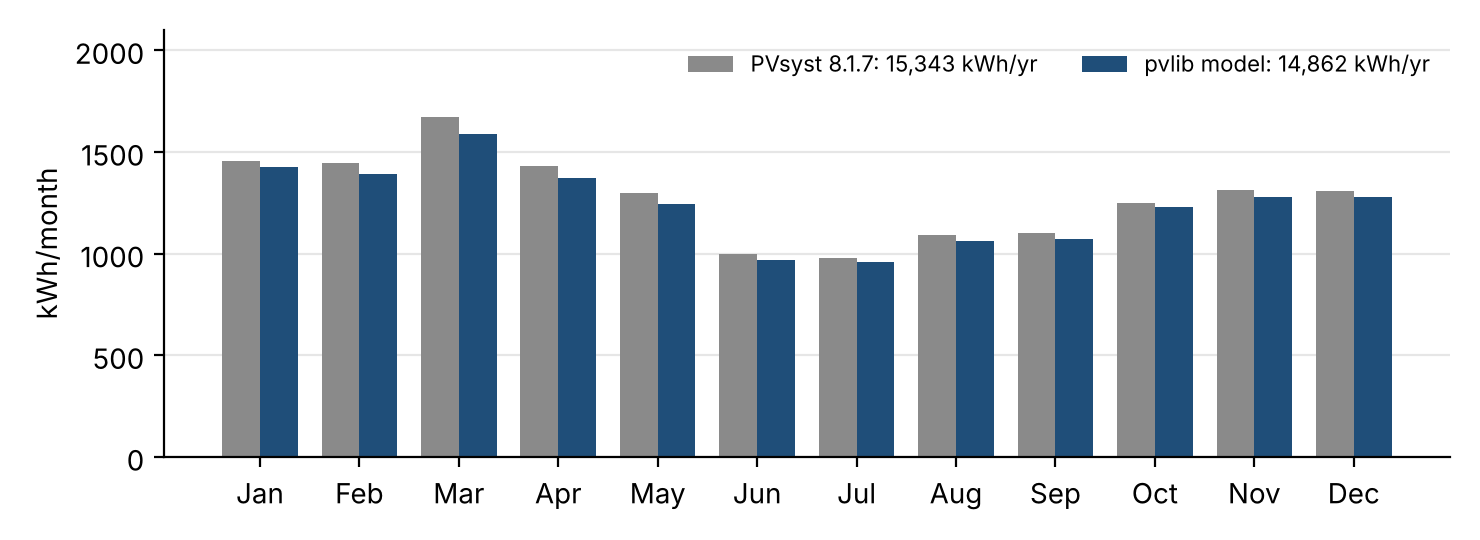
Solar_Portfolio_Projects_2-5/validation_P1.png
